davidkreidler/OpenCO2_Sensor/font/bahn.png

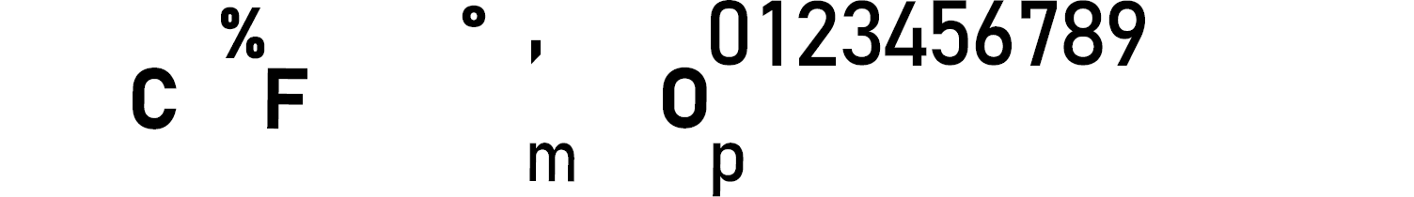
font/bahn.png
