davidkreidler/OpenCO2_Sensor/pictures/flowchart.png

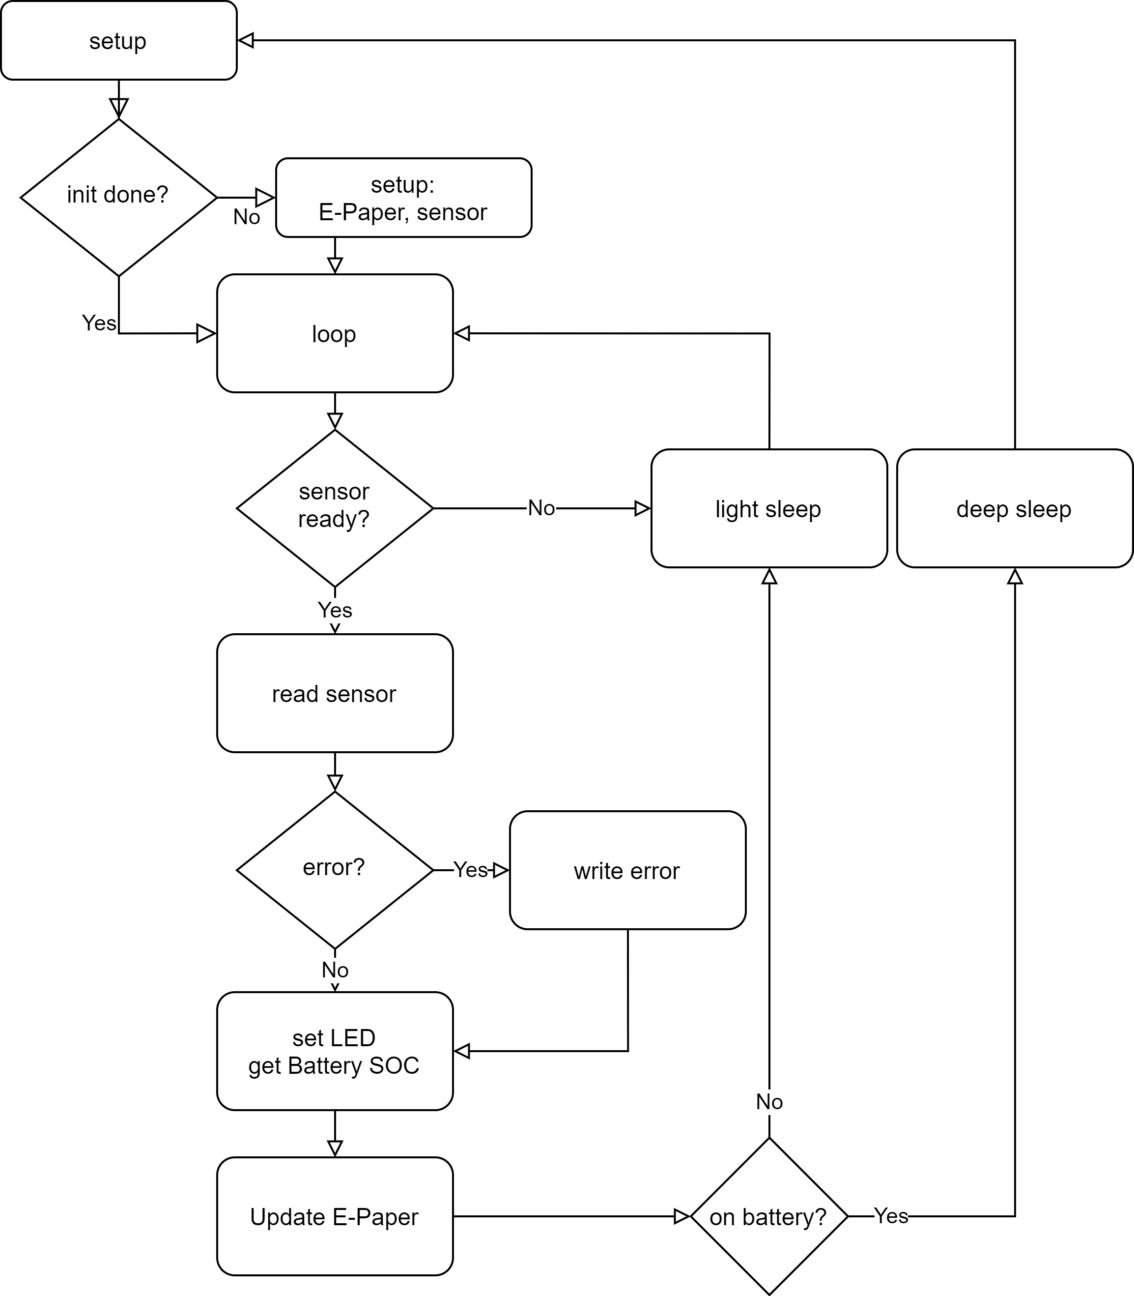
pictures/flowchart.png
