davidkreidler/OpenCO2_Sensor/pictures/header2.png

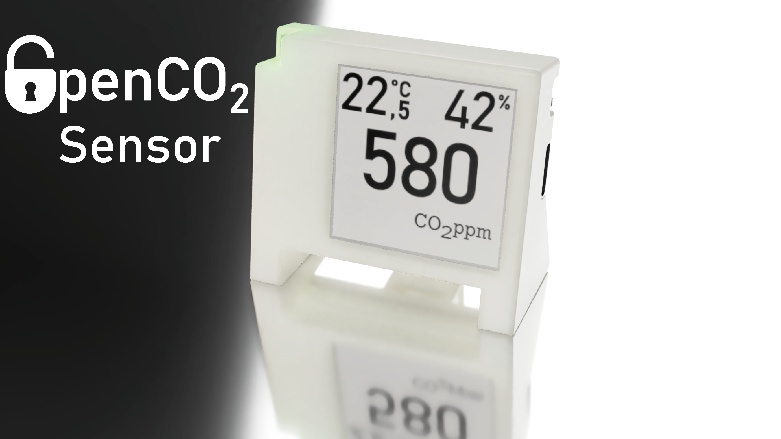
pictures/header2.png
