davidkreidler/OpenCO2_Sensor/pictures/components.png

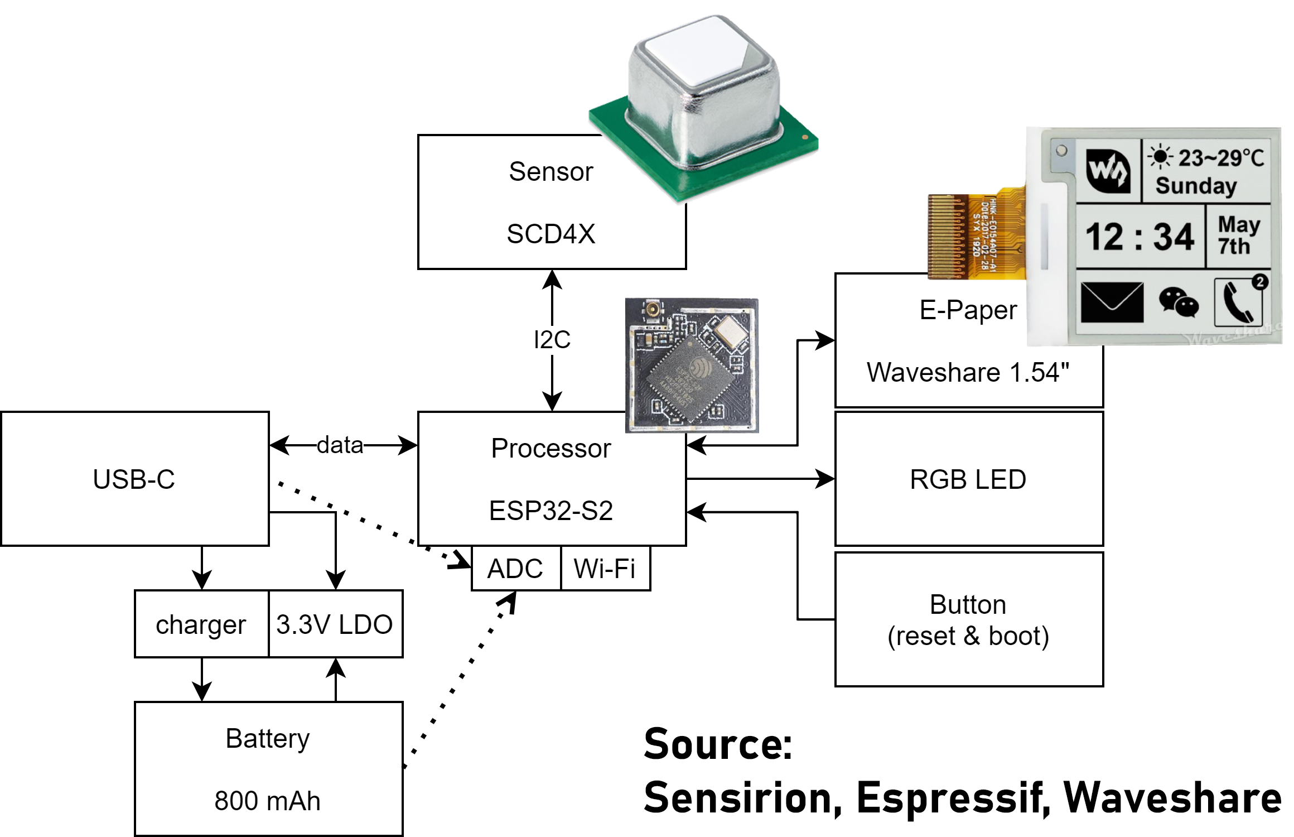
pictures/components.png
