davidkreidler/OpenCO2_Sensor/case/BACK.obj

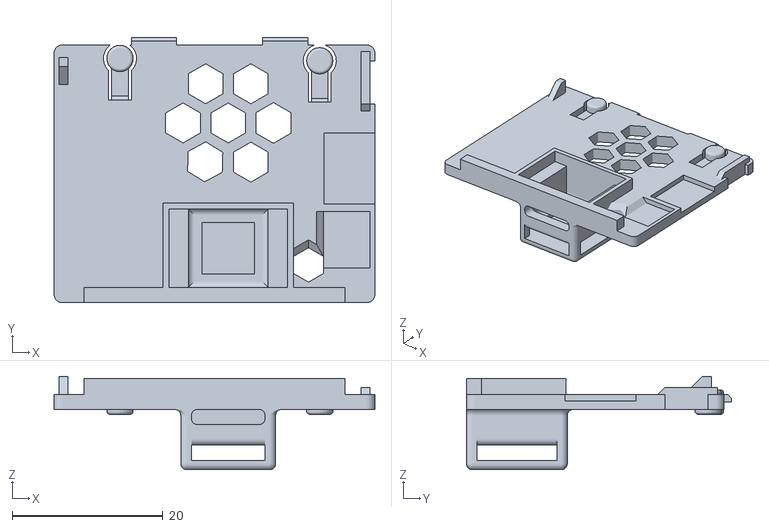
[picture p14: CAD file, 2023-07-02]
case/BACK.obj
42.6 x 35.2 x 12.4
