davidkreidler/OpenCO2_Sensor/case/FRONT.obj

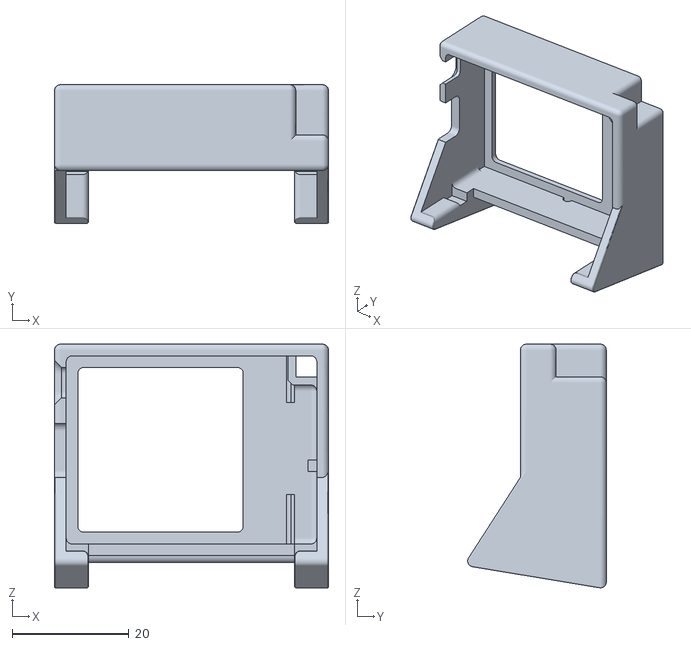
[picture p15: CAD file, 2023-07-02]
case/FRONT.obj
46.9 x 23.7 x 41.7
