davidkreidler/OpenCO2_Sensor/(threads)

Thread 2 (2022-03-26):

LED gets glitched into beeing on, but not reacting to co2 measurements. In BatteryMode.

Maashkinoozhe, 2022-03-26:
The led get stuck with a color and will not change until its reconnected to charging cable.
The software version is the one the sensor came with.
I have not done updates yet.

How to reproduce.

1. Sensor is disconnected from charging cable, LED is off.
2. Connect sensor with charging cable.
3. Disconnect charging cable as soon as the led switches on.

Expected Results:
1. Led stays on and changes color according to co2 measurements OR
2. Led turns off again and stays off

Actual Result:
Led stays on, even without charging cable.
Led color does not align with co2 values(co2 value changes, led color does not).
Led color is stuck on whatever color it had when "quick disconnecting" the sensor.

Closed 2022-10-02.

Thread 3 (2022-03-31):

getDataReadyFlag not found

chrho, 2022-03-31:
Hallo,

 wenn ich den main branch nehme und wie in der Readme beschrieben die Libs über die Arduino IDE installiere bekomme ich beim bauen die Fehlermeldung das es die Funktion nicht gibt. Ich hab auch in den Code der Lib geschaut da ist sie nicht enthalten. Kannst du mir sagen was ich falsch mache?

Gruß Christoph

davidkreidler, 2022-03-31:
Hey @chrho,
das ist eine sehr hilfreiche frage! Du benötigst die neuste Version der arduino scd4x Library:
github.com/Sensirion/arduino-i2c-scd4x in folgendem commit wurde die Funktion umbenannt:
https://github.com/Sensirion/arduino-i2c-scd4x/commit/4ec07965f30f32f4320960a04aadb7a19e6499c7

Einfach als ZIP downloaden und in der Arduino IDE importieren oder in den libraries Ordner entpacken.

Gruß
David

Closed 2022-10-02.

Thread 7 (2023-03-07):

where to order the sensor SCD40

volthouse, 2023-03-07:
where to order the sensor SCD40?

Thanks Volthouse

davidkreidler, 2023-03-07:
Hello @volthouse that is depending on how you want to use it.
There are development/breakout boards:
https://www.sparkfun.com/products/18365
https://www.adafruit.com/product/5187
https://sensirion.com/de/produkte/katalog/SEK-SCD41/

Or from [aliexpress](https://de.aliexpress.com/item/1005003974569988.html) **"SCD40 module"**

Its also possible to order the raw Sensor and solder it to a self designed PCB.

There is also the option to order the whole Open CO2 Sensor from [Tindie](https://www.tindie.com/products/davidkreidler/open-co2-sensor/). The next series with 150 devices is expected to arrive in April. Please join the waitlist if you are interested.

Thanks! David

Closed 2023-03-23.

Thread 9 (2023-04-15):

Sensor calibration

crener, 2023-04-15:
Hello,
Found this on Tindie and am extremely interested as this is something that I've wanted to build myself.

As I was looking at the sensor documentation to figure out what I would have todo to make it myself (was looking at the SCD41) I saw that there was an api for `set_sensor_altitude` (datasheet section 3.6.3) and `set_ambient_pressure` (section 3.6.5) each which calibrates the sensor so that it can perform higher accuracy measurements.

Is this something that is taken into account?

I was looking at the board and didn't see any pressure measurement sensors, for my project I was planning on using BMP384 to get this information... if this is something thats taken into account I would just buy yours on Tindie :)

davidkreidler, 2023-04-15:
Hey @crener thanks for reaching out. I take the sensor altitude into account here https://github.com/davidkreidler/OpenCO2_Sensor/blob/main/OpenCO2_Sensor.ino#L200 .
By default, it is set to 50 m above NN (because I'm from Berlin). This can be simply changed by you in the code and programmed into the sensor.

Air pressure is am interesting additional point! I I would highly encourage you to build a DIY version with a esp32 development board, a Waveshare 1.54" display, a SCD41 dev board and an air pressure sensor to find out potential benefits of this additional measurement.

In general the accuracy of the SCD40  is ±(50 ppm + 5% MV) @400-2000 ppm wich is more than enough to determine indoor air Quality (when to open a window). The Open CO2 Sensor also uses automatic self calibration by default to prevent potential long term drift. For this the Sensor needs ambient air exposure once peer week to automatically calibrate itself.

It would also be possible to by the Open CO2 Sensor on Tindie and add an external pressure sensor to the i2c bus here:
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

I hope this helps!
David

crener, 2023-04-16:
I guess it depends how much of an impact this has.

I think if it's noticeable people who use this in a tall building might have issues if the floor they are in is more than X meters above the ground (assuming that the setting is changed in their OpenCO2 unit).

Easy test might be to put two next to each other one with a 50m setting and another with 250m and see if the values are the same over the course of a day? I don't have any hardware on hand to build this (more of a software guy) so would take me a while to get an answer...

ThomasWaldmann, 2023-04-19:
Related article: https://gaslab.com/blogs/articles/altitude-compensation-co2-sensors

So it seems like a sensor calibrated at sea level (0m altitude) would display about 1% CO2 too much per additional 100m of altitude.

crener, 2023-04-19:
Hmm interesting read, for me that level of accuracy is fine with the default  but would make this unsuitable for people in mountains who aren't comfortable changing code and compiling to get a better base configuration for their location.

If you live in the Alps your village could be 1500m in elevation which would make all readings quite inaccurate.

Though i don't think anyone expects absolute accuracy from something like this, maybe the buttons on the back could be repurposed for some basic configuration?

davidkreidler, 2023-04-20:
Thanks for jumping on this discussion. The Building measurement idea would be defeated be the accuracy of the scd40 Sensor itself ±(50 ppm + 5% MV). At a 200m Height difference the difference would be 2% according to ThomasWaldmanns commend.

If you live in the Alps the automatic self calibration (ASC) of the SCD40 Sensor by Sensirion (a Swiss company) would do a great job in slowly adjusting to the Height. It needs to be exposed to ambient air.  This mode is enabled by default on my OpenCO2 Sensor.

 From the Datasheet:
"Field Calibration
To realize high initial and long-term accuracy, the SCD4x includes two field calibration features. [...] Automatic self-calibration (ASC) ensures highest long-term stability of the SCD4x without the need of manual action steps from the user. The automatic selfcalibration algorithm assumes that the sensor is exposed to the atmospheric CO2 concentration of 400 ppm at least once per
week."

ThomasWaldmann, 2024-05-04:
Is there a way to calibrate to 430ppm instead of 400ppm?

davidkreidler, 2024-05-04:
@ThomasWaldmann currently the calibration via the Menu ->Calibrate is defining the Environment to have 420ppm
https://github.com/davidkreidler/OpenCO2_Sensor/blob/v4.4/OpenCO2_Sensor.ino#L435
It can be changed there and then flashed onto the OpenCO2 Sensor.

For the automatic self calibration I sadly don't have the insides to know what the target is.

ThomasWaldmann, 2024-05-05:
Interesting that it is 420, my devices showed 400 after the calibration process with v4.4 (that's why I asked). Thanks for the pointer to where it can be adjusted.

Closed 2023-07-25.

Thread 10 (2023-07-21):

Font generation

volthouse, 2023-07-21:
Hello, with which tool can you generate your own fonts or convert free fonts?

davidkreidler, 2023-07-21:
Hey @volthouse thanks for reaching out. Its a bit more involved.

First, you can use the the template https://github.com/davidkreidler/OpenCO2_Sensor/blob/main/font/bahn.indd to insert your own font in the right size (3 times).
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

Then export it as png and use https://github.com/ayoy/font2bytes to convert it to binary.
./f2b -h 70 -w 47 bahn.png > bahn_big.cpp
./f2b -h 44 -w 29 bahn2.png > bahn_mid.cpp
./f2b -h 22 -w 13 bahn3.png > bahn_sml.cpp

Then import the result into you Arduino\libraries folder esp32-waveshare-epd\src\bahn*.cpp (it needs to be tweaked slightly).

If you have any questions please feel free to reach out.

volthouse, 2024-01-07:
Thank you for your reply, I apologise for my late reply, I have only just started working on my project again.

I am not familiar with INDD files, is it correct that it is an Adobe InDesign file format? Do I need Adobe software for this?

Many thanks for your help!

davidkreidler, 2024-01-08:
Yes the format is Adobe InDesign. You can also use any other Grafik Programm to create the Images for your font in the right format for https://github.com/ayoy/font2bytes .

Closed 2023-09-02.

Thread 12 (2023-11-06):

MQTT support

P1-Ro, 2023-11-06:
Would it be possible to add MQTT support? That way it could be easily connected to Home Assistant.

davidkreidler, 2023-11-06:
Hello @P1-Ro & thank you for reaching out regarding this.
Generally MQTT support is implemented but not jet fully validated.
I would appreciate your support regarding this a lot.

Currently its enabled via a special firmware or via your own build by enabling it here: https://github.com/davidkreidler/OpenCO2_Sensor/blob/main/OpenCO2_Sensor.ino#L40C10-L40C10
Please then also comment out "#define airgradient" and use esp board version 2.0.13

How to install it:
1. Download "OpenCO2_Sensor.ino.bin" from https://drive.google.com/file/d/1W8UEv53j-Czv9JsQuHC9AA_DrWFvl-n6/view?usp=sharing
2. Enable WiFi via the Menu on the OpenCO2 Sensor. Then connect a client to the new WiFi Network "OpenCO2 Sensor".
3. Navigate in your Webbrowser to http://192.168.4.1 (It also opens automatically on modern smartphones)
4.  Under Update select the OpenCO2_Sensor.ino.bin file and click Update. The Sensor will restart.

Connect again to the "OpenCO2 Sensor" network and insert your home network credentials and MQTT settings under "Configure WiFi".
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

P1-Ro, 2023-11-08:
Super stoked about that. I'll let you know when I have time for it :)

ThomasWaldmann, 2024-05-07:
Currently playing around with the MQTT enabled firmware, but already run into a problem:

The device was previously joined to a WiFi (so it does not open its own AP and show up under 192.168.4.1 any more), but I can ping it's home wifi IP.

How do I get the WiFiManager configuration web form now to enter the MQTT data? It does not seem to listen on port 80.

Thread 13 (2023-11-14):

Menue is not available and implausible Measurement

kraukl, 2023-11-14:
On my CO2-Sensor its impossible to engage the menue. Pressing the button on the back near the on/off switch (in battery mode or loading mode) only toggles LED on/off. In my printed mini-manual this button is called No.7 "LED On/Off".
Obviously my device is not the model that is described and shown online now. On my device there is an additional Reset button No. 8 which forces an instant measurement. I tried several different combinations of managing the 3 switches No. 6,7,8 without getting in the menue.

I wanted to update the device because the measurement behaviour is not sufficient. After storing in fresh air it shows 420-450 ppm and afterwords in the freshly ventilated room  it is creeping up implausibly quick and high. After moving it for testing into an airsealed and fresh air containing screwglass the CO2 raises up from initially 420 ppm to more than 2000ppm within 2 hours. It behaves in the sealed Glass as if its producing CO2 itself.

USB-Connection to my PC only affects a connection sound on the PC and no device shows up in the file manager.

I bougt the device at Tindie on 21 April 2023, Invoice No. #389420.
What can I do?

davidkreidler, 2023-11-14:
Hello @kraukl and thanks for reaching out and testing already.

To enable the Menu please update to the latest release (because it was developed after your purchase):
Instructions: https://github.com/davidkreidler/OpenCO2_Sensor#update-via-usb

Step by step:
- Download all files from the latest [release](https://github.com/davidkreidler/OpenCO2_Sensor/releases)
- Make sure, that the power switch is in the ON position (down)
- Plug a data USB-C cable (not the magnetic one) into your PC and the Sensor
- Hold the Button on the backside of the CO2 Sensor near the USB-C port and shortly push simultaneously the reset ↪️ Button
- In Windows Device Manager (Gerätemanager) under Ports (COM & LPT) find the COM number and modify it in update.bat
- Run update.bat via double click
- Afterwards push the reset ↪️ Button

This is only needed once. Afterwards or on new sensors its possible to update the Sensor over WiFi.
If you have any questions please feel free to reach out.

After the update its possible to do a manual calibration via the Menu (please put the Sensor outside while doing so).
Generally the CO2 level can rise quite quickly depending on factors like: How big is the room, how high is the sealing, how airtight is the room, how many people are in the room and for how long it was ventilated.
But you are right : during 2h in an air sealed container it should not rise. Only possibility I see is because CO2 is heavier then air it was collecting over time in the bottom close to the Sensor.

If these steps dont fix the observed behavior please reach out here and I will do an in depth analysis.
For this I then would like to kindly ask you to shipp the device to me. I will provide you a shipping label.

Thank you!
David

kraukl, 2023-11-17:
Thankyou david,
the update now worked.

But the unplausible measurement is still lasting.

Attached my handwritten 30 hrs log of a test in an airsealed 150ml screwglass after calibration in fresh air.
The CO2-Display raised from initially 446ppm to a maximum of 1488ppm after 19hrs.
Afterwards it gradually fell down furtheron to about constant 1000 to 1200ppm.

At first I assumed a faulty temperature compensation, but this obviously is not the reason (see temperatures & humidity values).

I would appreciate sending the device to you for a checkup as you kindly offered to me.

Best regards, manfred tischer

----------------------------------------------------------------------

Dienstag, 14. November 2023, 19:25:27, schriebst Du:

> Hello @kraukl and thanks for reaching out and testing already.

> To enable the Menu please update to the latest release (because it was developed after your purchase):
> Instructions: https://github.com/davidkreidler/OpenCO2_Sensor#update-via-usb

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

> This is only needed once. Afterwards or on new sensors its possible to update the Sensor over WiFi.
> If you have any questions please feel free to reach out.

> After the update its possible to do a manual calibration via the Menu (please put the Sensor outside while doing so).
> Generally the CO2 level can rise quite quickly depending on factors like: How big is the room, how high is the sealing, how airtight is the room, how many people are in the room and for how long it was ventilated.
> But you are right : during 2h in an air sealed container it should not rise. Only possibility I see is because CO2 is heavier then air it was collecting over time in the bottom close to the Sensor.

> If these steps dont fix the observed behavior please reach out here and I will do an in depth analysis.
> For this I then would like to kindly ask you to shipp the device to me. I will provide you a shipping label.

> Thank you!
> David

davidkreidler, 2023-11-29:
Evaluated the device and could not see a significant increase of CO2 inside a IKEA sealed container over 24h.
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

Also a comparison to a 3rd party device and a second sensor showed a static difference (likely doe to calibration).
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

One potential root cause of the increased CO2 Values was found in a call: The shift to colder temperatures because of the Winter season. This could have lead to a closed windows in the corridor. I will close the ticket for now.

kraukl, 2023-12-07:
Danke, das Gerät ist angekommen.

Herzlichen Dank für Ihre Bemühungen

Manfred Tischer

-----------------------------------------------------------
Mittwoch, 29. November 2023, 23:48:48, schriebst Du:

> Evaluated the device and could not see a significant increase of CO2 inside a IKEA sealed container over 24h.
> 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

> Also a comparison to a 3rd party device and a second sensor showed a static difference (likely doe to calibration).
> 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

> One potential root cause of the increased CO2 Values was found in a call: The shift to colder temperatures because of the Winter season. This could have lead to a closed windows in the corridor. I will close the ticket for now.

--
Mit freundlichen Grüßen,
Manfred Tischer

Closed 2023-11-29.

Thread 14 (2023-12-07):

Revised PCB

Blanketier, 2023-12-07:
I have run out of projects that I can make without spending an ungodly amount of money in R&D and me and a friend thought it would be fun if we mapped out the CO₂ monitor you have posted. You did not post the files for the schematic and board and only posted the images. looking at the schematic I have decided to just make a revised schematic with better power infrastructure and a few other misc. improvements. I was wondering if there is anyway to get in contact with you for you to explain some of your design choices?

davidkreidler, 2023-12-08:
Hey here is a good player to ask questions and I would love to see the power infrastructure changes. Thanks! David

Blanketier, 2023-12-08:
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
is the purpose of this section to switch between battery operated and usb powered depending on weather usb is plugged in?

davidkreidler, 2023-12-08:
Yes and to detect if USB is plugged in to go out of battery mode.

davidkreidler, 2023-12-09:
That's all parity Standart stuff. Almost every esp32 dev board uses these cheap components to protect the battery and only use it if USB is disconnected. The MOSFETs is conduction if USB is disconnected. And the diode otherwise powers the device. Using an expensive and not at my supplier lcsc available part is no improvement.

Closed 2023-12-17.

Thread 15 (2024-05-04):

update scripts for firmware 3.3 and 4.3 on POSIX OSes

ThomasWaldmann, 2024-05-04:
I finally updated my devices to the current firmware and had to make scripts for macOS due to the different executable name, usb-serial port name, UNIX style line endings, different needs for argument quoting, etc.

Guess if one changes the port name (which one has to check anyway), they would also work on Linux, BSD, etc.

I successfully tested them on a MacBook Pro with Apple Silicon here, but guess they also work on Intel. The scripts are based on the original `update*.bat` for Windows.

I also added some docs at the top of the scripts.

I had some v2.x devices, first upgraded to v3.3 (not sure if necessary), then upgraded to v4.3 using these scripts and a USB-C cable.

To upgrade to v4.4, I then used the OTA web-based firmware upload method via WiFi.

## update_fw_3.3_wifi_macos.sh
```
## Updating the OpenCO2 sensor to firmware release 3.3 (with wifi) on macOS.
# 0. download all the .bin files of the 3.3 release from github releases page and put them into current directory.
# 1. brew install esptool    (or somehow else have a working esptool.py)
# 2. OpenCO2 sensor: press and hold the button close to the usb port, then shortly press the reset button on the other side.
# 3. execute this script.
esptool.py --chip esp32s2 --port /dev/tty.usbmodem01 --baud 921600 --before default_reset --after hard_reset write_flash -z --flash_mode dio --flash_freq 80m --flash_size 4MB 0x1000 OpenCO2_Sensor.ino.bootloader.bin 0x8000 OpenCO2_Sensor.ino.partitions.bin 0xe000 boot_app0.bin 0x10000 wifi.bin
```
## update_fw_4.3_wifi_macos.sh
```
## Updating the OpenCO2 sensor to firmware release 4.3 (with wifi) on macOS.
# 0. download all the .bin files of the 4.3 release from github releases page and put them into current directory.
# 1. brew install esptool    (or somehow else have a working esptool.py)
# 2. OpenCO2 sensor: press and hold the button close to the usb port, then shortly press the reset button on the other side.
# 3. execute this script.
esptool.py --chip esp32s2 --port /dev/tty.usbmodem01 --baud 921600 --before default_reset --after hard_reset write_flash -z --flash_mode dio --flash_freq 80m --flash_size 4MB 0x1000 OpenCO2_Sensor.ino.bootloader.bin 0x8000 OpenCO2_Sensor.ino.partitions.bin 0xe000 boot_app0.bin 0x10000 OpenCO2_Sensor.ino.bin
```

davidkreidler, 2024-05-04:
Thank you very much for sharing the details on how to update under macOS using esptool.
This process was not scalable at none tech enthusiastic costumers. For all (new) devices running V4.4+ when they get connected via USB to a computer they emulate an USB flash drive to enable copy pasting of [FIRMWARE.BIN](https://github.com/davidkreidler/OpenCO2_Sensor/releases/download/v4.4/FIRMWARE.BIN)

Closed 2025-01-26.

Thread 18 (2024-05-20):

Several reboots during charging (v4.5)

nm, 2024-05-20:
After upgrading to v4.5, I have experienced several reboots during charging. Everything is fine in battery mode.
After downgrading to v4.4 the reboots are gone.

Does anyone else have this problem?
Maybe related to https://github.com/davidkreidler/OpenCO2_Sensor/commit/e351ebc04f1215ceaa1af4050829d22f6743a42b?

davidkreidler, 2024-05-20:
Hey @nm thanks for updating to the latest version and sharing your experience. The commit you shared is only active in battery mode when going to deep sleep...

Most likely the instability is related to an updated ESP32 boards version to
"Arduino Release v2.0.16 based on ESP-IDF v4.4.7".
arduino-esp32 https://github.com/espressif/arduino-esp32/compare/2.0.13...2.0.16

Here is a OpenCO2 v4.5 build based on ESP "Arduino Release v2.0.13":
https://drive.google.com/file/d/1mw3rHz8mlEjAy6Y1W7xySc4TDw19aKiD/view?usp=sharing

Would you please flash it and report back if the issue is fixed?

Thanks!
David

nm, 2024-05-22:
Thanks @davidkreidler,
with the updated build the issue is fixed.

davidkreidler, 2024-05-22:
Perfect thanks for confirming. I will debug this further.

Closed 2024-05-22.

Thread 19 (2024-06-22):

Please add `LICENSE` file to repository

penyuan, 2024-06-22:
Thanks for making this amazing open source CO2 sensor! Just ordered one on Tindie, can't wait to receive it soon. ❤️

Can @davidkreidler please include a `LICENSE` file in this repository? GitHub has [easy steps](https://docs.github.com/en/communities/setting-up-your-project-for-healthy-contributions/adding-a-license-to-a-repository) for doing so, and there are [hardware-specific open source licenses](https://choosealicense.com/non-software/) such as [CERN-OHL-S-2.0](https://choosealicense.com/licenses/cern-ohl-s-2.0/).

Happy to send a Pull Request if helpful.

Thanks!

davidkreidler, 2024-06-25:
Hey @penyuan thank you for your purchase! Ive added a MIT licence in this commit: https://github.com/davidkreidler/OpenCO2_Sensor/commit/a705ffd5d7deb6f2e755a6baa1590b5d50c6ddbf

David

penyuan, 2024-06-25:
> Hey @penyuan thank you for your purchase! Ive added a MIT licence in this commit: [a705ffd](https://github.com/davidkreidler/OpenCO2_Sensor/commit/a705ffd5d7deb6f2e755a6baa1590b5d50c6ddbf)
>
> David

Awesome, thank you so much! 🙇🏼‍♂️

Closed 2024-06-25.

Thread 20 (2024-06-26):

Bigger clock

saviola777, 2024-06-26:
Hello, great little device!

How difficult would it be to add a setting to have a bigger clock at the bottom, replacing the "12:31 <WiFi-Symbol> co2ppm"? Both the wifi symbol and the co2ppm are kind of unnecessary to me (the former since the clock is only shown when connected to wifi anyway, the latter because well, I know the units!). As it is, the clock is a bit hard to read for someone without perfect vision (like me).

Of course nobody else might be interested in something like this so it might not be worth it. If that's the case, maybe you could give me some pointers how to implement something like that myself? (I do have a computer science background, but have never worked with ESP / Arduino IDE etc.)

Thanks!

PS: I don't really want to open another issue for this because it's not really a problem, just something maybe worth documenting: after opening/closing the menu, calibration, reboots etc., all sensor values (mostly temperature and humidity) are random and several hours to slowly come back to the correct values. It's not a big deal, but it seems like something easily fixed by starting from the last known values?

davidkreidler, 2024-06-26:
Hey @saviola777 , thanks for reaching out and Im always happy about improvement suggestions.
The size and position of the time is programmed here: https://github.com/davidkreidler/OpenCO2_Sensor/blob/main/epd_abstraction.ino#L951
The WiFi Symbol is programmed just above it. I've made the change for the next upcoming release:
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

You can download a preview firmware here: https://drive.google.com/file/d/1CZV0PkfPjihIBflSv7b6Stn6vJallcpi/view?usp=sharing
Install it by plugging in a data USB-C cable into your PC and the Sensor. Then copy FIRMWARE.BIN to the USB device.

Regarding the temperature and humidity values: Because of self heating of the whole sensor when WiFi is activated a relatively large temperature offset of 13°C is applied automatically when WiFi is active. Without WiFi only a 4.4°C offset is applied.
On Battery the offset is only 0.8°C. https://github.com/davidkreidler/OpenCO2_Sensor/blob/main/OpenCO2_Sensor.ino#L174

Since this self heating takes some time the temperature and humility values might be off after a cold start.  If you know any possibility to decrease the power consumption of the ESP32 using WiFi as a client, I would appreciate the help. Switching to matter or esphome might improve this. But with less convenience access to the values and the initial WiFi setup.

saviola777, 2024-06-27:
Awesome, thank you! Works like a charm. I guess it makes sense with the heat, I did not think about that at all.

I had it running overnight on battery and it showed 16°C and 10% humidity this morning (real values were closer to 26.5°C and 60%, unfortunately). Maybe that was also related to the offset somehow? But I'm planning to have it run on power constantly anyway (connected to the USB port of my FritzBox), or would you recommend against that because of power usage?

While powered, the temperature seems to be off by about -1°C, humidity by +5% (if I can trust the readings of this other sensor which I'm not sure about), which is within an acceptable range (and something I could manually fix by changing the offset in the code once I figure out how to build the firmware myself).

I suppose I could disable WiFi, but I really like that clock. :smile:

davidkreidler, 2024-06-29:
As I understand you had it on Battery over night and then plugged it in? Then the temperature was then lower then expected. If yes, this is exactly what the offset causes. Its applied instantly but the device was not heated up jet.

The specs for accuracy are:
Temperature ±0.8°C
Humidity ±6%

Instructions for setup the programming Environment can be found here:
https://github.com/davidkreidler/OpenCO2_Sensor?tab=readme-ov-file#installation-inside-the-arduino-ide

Running it plugged in to your fritzbox is totally fine. Power consumption is about 0,1 Watt or while charging up to 3 Watt. For long long term usage like this you could think about charging the battery to around 60% and then unplugging it.

saviola777, 2024-07-03:
As a small addendum: I tested it without WiFi and the values for both temperature and humidity are now exactly the same as on my other sensors. I guess the offsets for WiFi don't work in all situations (for me it was always temperature 0.8-1.0° too high and humidity 4-5% too low), or maybe it needs a linear offset depending on measured values, I don't know.

I decided to give up on the clock for now and run without WiFi, maybe one day I'll set up a development environment and tinker with different offsets.

davidkreidler, 2024-07-03:
Hey @saviola777 thanks for the follow up. I did a deep dive and build a debug firmware that shows the applied offset in the Menu -> Info point. By doing this I found a but that was introduced in v4.6 with the faster wifi response time.
The change from usb power mode to battery mode lead to a case where the offset was not applied because comingFromDeepSleep was set incorrectly (because there was no new measurement value after 500ms).

Fix:
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

Now the offset is correctly applied when going into Batery mode.

Also compared the temperature while using wifi and you are correct. Compared to a reference device I could see a about 0.8°C difference. Likely root cause of the lower offset requirement is that I switched from 240MHz to 80MHz mode. The new offset will be allied in the next release:
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

Thank you for pointing out these bugs! Here is a preview:
https://drive.google.com/file/d/1StSAuJfoRrM6ONd-Y4JslkN3VltMClaX/view?usp=sharing

saviola777, 2024-07-04:
Awesome, thanks! Temperature now within 0.3 of the other sensor which is great. Humidity is off by 6% (too high), do you have an explanation for that? Does the sensor use the measured temperature to determine the humidity or something which leads to wrong values with the WiFi heat? Do we need an offset here as well?

It's not a big deal of course, and it's also possible my other sensor is wrong, but without WiFi the humidity readings were within 1% from the other sensor.

davidkreidler, 2024-07-07:
The claimed accuracy of the scd40 sensor by sensirion  is +-6% for humidity. So this would be within spec. Inside the scd40 itself it's only possible to set a temperature offset it also affects the calculation for the humidity.

Hope this helps!
David

saviola777, 2024-07-07:
Yeah that's fine. I just find it weird that it's always exactly +4-6% above my other sensor when on WiFi and within +-1% of the other sensor when without WiFi. I guess it would be simple to alter the recorded/displayed humidity reported by the sensor depending on the WiFi status, maybe I'll try to make that change.

davidkreidler, 2024-07-07:
Go for it! If you need help please ask.

Closed 2024-06-27.

Thread 21 (2024-07-21):

Document how to extract current sensor values programmatically

saviola777, 2024-07-21:
Hello,

this is probably trivial to figure out if one knows anything about Prometheus/Grafana, but maybe it would be useful to document how to use `curl` / `wget` or similar to extract current sensor values from the device over WiFi in a machine-readable format.

The website is cool and all, but I would prefer to integrate the information directly into my system to e.g. remind me to open/close the windows depending on sensor values and inside/outside temperatures.

davidkreidler, 2024-07-21:
Hey @saviola777 thanks for reaching out. Great suggestion to add a quick how to get values instructions.

First please find out the IP of the sensor in your home network via the ui of your router or on the sensor itself via the button under Menu -> Info .

Then insert the IP here and use
`wget -S -O - [IP]:9925/metrics`

Or `wget [IP]:9925/metrics
cat metrics`

Or via curl example

`curl 10.0.0.101:9925/metrics`
```
# HELP rco2 CO2 value, in ppm
# TYPE rco2 gauge
rco2{id="Open CO2 Sensor",mac="7C:DF:A1:96:B9:72"}571
# HELP atmp Temperature, in degrees Celsius
# TYPE atmp gauge
atmp{id="Open CO2 Sensor",mac="7C:DF:A1:96:B9:72"}25.37
# HELP rhum Relative humidity, in percent
# TYPE rhum gauge
rhum{id="Open CO2 Sensor",mac="7C:DF:A1:96:B9:72"}55.15
```

Hope this helps, I will add it to the README

David

saviola777, 2024-07-21:
Perfect! Thanks.

Closed 2024-07-21.

Thread 22 (2024-07-28):

Wifi not available on battery ?

YannDanthu, 2024-07-28:
Hello,

first of all thank you for making the OpenCO2 sensor.

Quick question related to the wifi, as it is only available while on power and not on battery.
Is this because of energy consumption ?

Also, while on power the temperature is messed up and not accurate anymore, probably by the heat generated by the charging battery.

Do you plan to allow wifi on battery in the future ?

davidkreidler, 2024-07-28:
Hey @YannDanthu  thanks for reaching out.

The current Wi-Fi implementation is only active if power is connected. You are correct this is for energy saving reasons. There are no hardware limitations that limit the activation on Battery, but a good energy saving implementation like ESP-NOW would be recommended.

There is one esphome implementation by Yourigh available with some limitations (no LED / Menu / limited Fonts)
https://github.com/Yourigh/OpenCO2_Sensor_esphome/tree/main

Other then that my main focus until now was not on enabling WiFi on Battery. This is because the use case was to use the OpenCO2 Sensor on Battery while being on the go and plugging it back in when coming Home, automatically enabling WiFi.

While charging elevated temperatures are expected because of the used TP4065 which lowers the 5V USB Voltage to the current Battery voltage via dissipating heat. Charging from empty to full should be completed after less then 1:50 h.

Hope this helps,
David

YannDanthu, 2024-07-28:
thanks for the answer.

One last question, I didn't dig into it yet but would it be easy to publish the metrics to an endpoint from the CO2Sensor (instead of pulling from another device)

Thread 23 (2024-11-04):

FIY: Homeassistant configuration

Finkregh, 2024-11-04:
I added this config to the `configuration.yml` of my homeassistant.

You can use https://www.uuidgenerator.net/version4 to generate your own individual IDs and assign an area in the UI after a reload.

```yaml
rest:
    scan_interval: 60
    resource: http://IPADDRESSorHOSTNAME:9925/
    method: GET
    sensor:
      - name: "NAME Co2"
        device_class: carbon_dioxide
        unique_id: "d611314f-9010-4d0d-aa3b-37c7f350c82f"
        value_template: >
            {{ value | regex_findall_index("(?:rco2.*})(\d+)") }}
      - name: "NAME Temperature"
        unique_id: "d611314f-9010-4d0d-aa3b-37c7f350c821"
        device_class: temperature
        value_template: >
            {{ value | regex_findall_index("(?:atmp.*})((?:\d|\.)+)") }}
      - name: "NAME Humidity"
        unique_id: "d611314f-9010-4d0d-aa3b-37c7f350c822"
        device_class: humidity
        value_template: >
            {{ value | regex_findall_index("(?:rhum.*})((?:\d|\.)+)") }}
```

Further documentation:
- https://www.home-assistant.io/integrations/rest/
- https://www.home-assistant.io/integrations/sensor.rest

Feel free to add it to the readme or where appropriate. Thanks for your work <3

davidkreidler, 2024-11-09:
Hey @Finkregh and thank you very much for sharing the Home Assistent config.
Ive added it to the readme with some minor changes: First I added a general hostname in v5.4: "openco2".
In newer Versions there is also a graph website under that main URL and the Maschine readable one is http://OpenCO2:9925/metrics

https://github.com/davidkreidler/OpenCO2_Sensor/commit/25bb626ea4bfb275eadd7216eeef7a7a6f9cd242

Ruinenlord, 2025-02-18:
Hello,

I, as a beginner, read in different forums about the rest integration and tried everything to add more than one sensor to Home Assistant. A single one works fine, but I'm not able to modify the code without getting errors "duplicate mapping key".

I would like to read the dates from three sensors.

Could anyone modify the code for me? Thanks a lot for helping.

Finkregh, 2025-02-18:
Did you generate individual uuids?

Ruinenlord, 2025-02-19:
This is one part, I was wondering about. How can I define unique IDs for every sensor?

davidkreidler, 2025-02-19:
In the script by Finkregh above there are example values in the unique_id field. I think you can freely define your own as long as they are different for every Sensor / value. You also need to add each unique IP address in the resource field.

In the API I'm also providing the Mac address of every Sensor example:

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

Ruinenlord, 2025-02-19:
Ok, thank you, I will have a try.

Closed 2024-11-09.

Thread 26 (2025-01-21):

FR: Manual IP settings

mikispag, 2025-01-21:
It would be cool to allow manual IP settings (IP, gateway, DNS) instead of forcing DHCP. I believe WifiManager has an example set for this use case, so it should not be too hard to implement.

davidkreidler, 2025-01-21:
Hey @mikispag thanks for reaching out.
I see the option to set a static IP at compile time in the wifimanager here:
https://github.com/tzapu/WiFiManager/blob/master/examples/Advanced/Advanced.ino#L57
There is also the option to "show static IP/DNS fields" below. But for normal costumers this might be a bit complex.

For a test Ive added it here:
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
Result is this field on the wifi connect page:
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

If you would like to trial it here is the binary:
https://drive.google.com/file/d/1Iz7nN6zynmJLcX0xWQRZ1jldBMAmfOK_/view?usp=sharing

Hope this helps,
David

mikispag, 2025-01-21:
Wow, that was fast! Thank you very much, David.

I believe showing the fields in a collapsible way (hidden under a "Static IP settings" or "Advanced IP settings") should not be too bad for regular users, but it's your call!

Two questions: could you make the binary in English and how do I forget the saved WiFi info (reset)? I didn't find documentation about this.

davidkreidler, 2025-01-21:
The language can be change on the Sensor itself via the Menu -> Display -> German/English
The easiest way to "forget" the stored WiFi is to just walk away from the position where the known Wifi is active. Otherwise the only current way is to use the Arduino IDE Option under Tools -> "Erase All Flash Before Sketch Upload" -> Enabled.

Welcome!

mikispag, 2025-01-21:
Thanks, works perfectly. Could also delete the WiFi config in the Info section of the portal.

Cheers!

Closed 2025-01-21.

Thread 27 (2025-02-21):

WPA3

darksnakezero, 2025-02-21:
Very sorry to contact you this way, but the tindie website refused to let me contact you directly.

Is the sensor able to connect to a WPA3 wifi network?

davidkreidler, 2025-02-21:
Hey @darksnakezero thanks for reaching out normally tindie has a kind of forum to exchange messages. But here is also a good place to reach out.

Yes, the ESP32-S2 I use has this on its Feature List https://docs.espressif.com/projects/esp-idf/en/latest/esp32s2/api-guides/wifi.html#esp32-s2-wi-fi-feature-list
- WPA/WPA2/WPA3/WPA2-Enterprise/WPA3-Enterprise/WAPI/WPS and DPP

At home I use WPA3 in transition mode on my Fritzbox without issues.

Closed 2025-02-24.

Thread 28 (2025-02-23):

Influence of humidity on CO2 concetration measurement

saviola777, 2025-02-23:
Hello again,

I wanted to ask if you have any information on the effect of relative humidity on the measured CO2 concentration for the employed sensor?

For a couple of months I had very low humidity (~30%) in my apartment and I noticed that the measured CO2 concentration seemed much lower than before (after ventilating for ~10 minutues in the morning I could go 8+ hours and it would still show less than 1000ppm). Now I have a (fan-based) humidifier and the humidity is back to around ~45% and around 3 hours after ventilating the apartment down to ~600ppm the CO2 concentration is at 1100ppm.

davidkreidler, 2025-02-24:
Hey @saviola777 thanks for reaching out, again :D
The SCD40 has an included humidity/temperature sensor to compensate this for accurate CO2 measurements. According to the Datasheet: "Accuracy can be reduced at relative humidity levels lower than 10%.". And:

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

Maybe in your case there are other factors at play like for example a tiny gap in one of the Window seals or an open window in the hallway?

Also if after 3 hours of (across?) ventilation only 600ppm is reached I would recommend a re calibration via the Menu by placing the sensor outside and after a few minutes start the re calibration. Automatic self calibration is enabled by default but maybe there was an Event, bringing it out of spec.

Closed 2025-02-24.

Thread 31 (2025-05-12):

Stuck in TEST_MODE (?) after update to 5.6

jujupsy, 2025-05-12:
Hello,

I have just updated the firmware to 5.6 via USB.
However, I now see the voltage and other information (MAC address and serial) instead of the time / battery.

I already tried to flash it with the Arduino IDE (settings: Erase all Flash enabled & USB Firmware MSC enabled), but that didn't change anything.

Looking at the code, I'm assuming it has to do with TEST_MODE, but I'm not sure.

Any help or ideas to fix this are greatly appreciated :)

davidkreidler, 2025-05-12:
Hey @jujupsy thanks for reaching out. To exit TEST_MODE: please push the button while the sensor is in Battery mode. This will trigger displayWelcome() and write the EEPROM value. https://github.com/davidkreidler/OpenCO2_Sensor/blob/main/OpenCO2_Sensor.ino#L778

David

jujupsy, 2025-05-12:
Perfect! That worked!

Many thanks for the very quick reply.

Closed 2025-05-12.

Thread 35 (2025-07-01):

stuck on welcome screen after update to 5.7

xBorsti, 2025-07-01:
Hi,

my unit is stuck on the welcome screen, the one with the House and the stopwatch, after updating to 5.7 via USB. Same happens on 5.6 and 5.5. i did not try to go any lower, cause it seems like a deeper problem.

If i push the button on the back and exit the menu the sensors stay at 400ppm the clock gets updated but nothing else.

If i activate WLAN i also cant connect to openco2:9925 but have to use my IP:9925, but that may be another Problem.

Is there a way for me to reset the unit and start over?

xBorsti, 2025-07-01:
Hi thanks for the help, i bought the unit on 27th of June.

Closed 2025-07-01.

Thread 36 (2025-07-25):

Can't reach the device

andreapx, 2025-07-25:
Hi, sorry to write here, but I don't have any other contacts.
I've bought your device, I've set it up, I can ping it, but I can't connect to port 9925. It doesn't even respond to telnet.
What can I check?
Thanks!

davidkreidler, 2025-07-25:
Hey @andreapx here is exactly the right place to reach out regarding software topics.
MQTT is currently not activated by default, but you can use the Maschine readable UI under
http://openco2:9925/metrics
OR http://[IP]:9925/metrics
The IP can be found by pressing the Menu button on the back of the OpenCO2 Sensor and navigating to Info.

There is only an early beta implementation of MQTT. But it was not tested jet. In case you would like to trial it:
Please recompile via Arduino IDE with this enabled: https://github.com/davidkreidler/OpenCO2_Sensor/blob/main/OpenCO2_Sensor.ino#L52
and this commented out: https://github.com/davidkreidler/OpenCO2_Sensor/blob/main/OpenCO2_Sensor.ino#L44
Then, in the wifi setup assistant website you find the field for the IP.

If your goal is to include the OpenCO2 Sensor into your home assistant please just follow the instructions here: https://github.com/davidkreidler/OpenCO2_Sensor/tree/main?tab=readme-ov-file#home-assistant

regards,
David

Thread 37 (2025-07-30):

Device doesn't connect to hidden network

andreapx, 2025-07-30:
Hi!
I've noticed that the device doesn't connect to hidden network.
I've created an IoT WiFi network, I've connected the device to it and all was good.
I've then hidden the WiFi network and as soon as I've restarted the CO2 device it didn't connect anymore to the network.
Can this problem be solved?

davidkreidler, 2025-07-30:
Hey @andreapx to connect to WiFi the [WiFiManager](https://github.com/tzapu/WiFiManager) library is used. For hidden SSIDs, you must manually specify the SSID and password, as the ESP32 cannot detect the network during a scan. Please try to setup your hidden SSID via the portal again.

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

andreapx, 2025-07-31:
@davidkreidler I've hidden the network after I've connected the device.
I all was working and when I've hidden it and restarted the devices, it didn't reconnect anymore to the network.

davidkreidler, 2025-07-31:
Yes I've got that. My assumption is, that after the visibility flag of the SSID changed, it needed to be setup again in the OpenCO2 Sensor. Please try to set it up again. Otherwise creating an issue in the  wifimanger repro might be the way to go.

Closed 2025-09-16.

Thread 40 (2025-08-29):

humidity constantly rising

xBorsti, 2025-08-29:
Hi,

one of my three units does not measure humidity very well. Its constantly rising till it reaches 100%. Then after some time it shuts down and stops sending measurements.

Is the unit broken? or is there a way to reset the humidity sensor?

its a newer Model, bought in July, and it only starts with Firmware 5.8

Protarios, 2025-09-16:
Hi, have kind of the same problem.
The sensor is always above 80% humidity and alsontemp is 4°C off.
Recieved the sensor this week and also calibration does not help.

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

davidkreidler, 2025-09-16:
Hey @Protarios depending on the Environment (especially on WiFi: based on airflow and signal strength) the default Temperature offset might needs to be adjusted. https://github.com/davidkreidler/OpenCO2_Sensor/blob/main/OpenCO2_Sensor.ino#L320
On WiFi the default one is 12.2°C. In your case 8.7°C might be best. This also affects the humidity calculation.

Regarding the calibration: its only affecting the CO2 Value.

Here https://drive.google.com/file/d/1aH6IWMQoNFT6ZVr_A-WsNftiHss08SzY/view?usp=sharing is a Firmware build with that offset. Please update the OpenCO2 Sensor by connecting it with the switch in the OFF position via a data USB cable to your PC. Afterwards switch it to on and copy the FIRMWARE.BIN to the USB-Storage device. Thanks!
