davidkreidler/OpenCO2_Sensor/esp32-waveshare-epd/src/DEV_Config.cpp

/*****************************************************************************
* | File      	:   DEV_Config.c
* | Author      :   Waveshare team
* | Function    :   Hardware underlying interface
* | Info        :
*----------------
* |	This version:   V1.0
* | Date        :   2020-02-19
* | Info        :
#
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
******************************************************************************/
#include "DEV_Config.h"
#include <SPI.h>

void GPIO_Config(void)
{
    pinMode(EPD_BUSY_PIN,  INPUT);
    pinMode(EPD_RST_PIN , OUTPUT);
    pinMode(EPD_DC_PIN  , OUTPUT);
    
    //pinMode(EPD_SCK_PIN, OUTPUT);
    //pinMode(EPD_MOSI_PIN, OUTPUT);
    pinMode(EPD_CS_PIN , OUTPUT);

    //digitalWrite(EPD_CS_PIN , HIGH);
    //digitalWrite(EPD_SCK_PIN, LOW);
}
/******************************************************************************
function:	Module Initialize, the BCM2835 library and initialize the pins, SPI protocol
parameter:
Info:
******************************************************************************/
UBYTE DEV_Module_Init(void)
{
	//gpio
	GPIO_Config();

    SPI.begin(EPD_SCK_PIN, -1, EPD_MOSI_PIN, -1);  //sck,miso,mosi,ss
    SPI.beginTransaction(SPISettings(2000000, MSBFIRST, SPI_MODE0));

	//serial printf
	//Serial.begin(115200);

	// spi
	// SPI.setDataMode(SPI_MODE0);
	// SPI.setBitOrder(MSBFIRST);
	// SPI.setClockDivider(SPI_CLOCK_DIV4);
	// SPI.begin();

	return 0;
}

/******************************************************************************
function:
			SPI read and write
******************************************************************************/
void DEV_SPI_WriteByte(UBYTE data)
{
    //SPI.beginTransaction(spi_settings);
    digitalWrite(EPD_CS_PIN, GPIO_PIN_RESET);
    SPI.transfer(data);

    /*for (int i = 0; i < 8; i++)
    {
        if ((data & 0x80) == 0) digitalWrite(EPD_MOSI_PIN, GPIO_PIN_RESET); 
        else                    digitalWrite(EPD_MOSI_PIN, GPIO_PIN_SET);

        data <<= 1;
        digitalWrite(EPD_SCK_PIN, GPIO_PIN_SET);     
        digitalWrite(EPD_SCK_PIN, GPIO_PIN_RESET);
    }*/

    //SPI.transfer(data);
    digitalWrite(EPD_CS_PIN, GPIO_PIN_SET);
    //SPI.endTransaction();	
}
