davidkreidler/OpenCO2_Sensor/pictures.c

#include "pictures.h"

const unsigned char gImage_init[5000] = { /*0X00,0X01,0XC8,0X00,0XC8,0X00,*/
0XFF,0XFF,0XFF,0XFF,0XFF,0XFF,0XFF,0XF7,0XF7,0XFF,0XFF,0XFF,0XFF,0XFF,0XFF,0XFF,
0XFF,0XFF,0XFF,0XFF,0XFF,0XFF,0XFF,0XFF,0XFF,0XFF,0XFF,0XFF,0XFF,0XFF,0XFF,0XFF,
0XE3,0XE3,0XFF,0XFF,0XFF,0XFF,0XFF,0XFF,0XFF,0XFF,0XFF,0XFF,0XFF,0XFF,0XFF,0XFF,
0XFF,0XFF,0XFF,0XFF,0XFF,0XFF,0XFE,0X0F,0XFF,0XE7,0XE3,0XFF,0XFF,0XFF,0XFF,0XFF,
0XFF,0XFF,0XFF,0XFC,0X00,0XFF,0XFF,0XFF,0XFF,0XFF,0XFF,0XFF,0XFF,0XFF,0XFF,0XE0,
0X0F,0XFF,0XE7,0XF3,0XFF,0XFF,0XFF,0XFF,0XFF,0XFF,0XFF,0XFF,0XF0,0X00,0X3F,0XFF,
0XFF,0XFF,0XFF,0XFF,0XFF,0XFF,0XFF,0XFF,0X00,0X0F,0XFF,0XE7,0XF3,0XFF,0XFF,0XFF,
0XFF,0XFF,0XFF,0XFF,0XFF,0XE0,0X00,0X1F,0XFF,0XFF,0XFF,0XFF,0XFF,0XFF,0XFF,0XFF,
0XFC,0X00,0X1F,0XFF,0XE7,0XF3,0XFF,0XFF,0XFF,0XFF,0XFF,0XFF,0XFF,0XFF,0XE1,0XFE,
0X1F,0XFF,0XFF,0XFF,0XFF,0XFF,0XFF,0XFF,0XFF,0XF0,0X00,0X0F,0XFF,0XE3,0XE3,0XFF,
0XFF,0XFF,0XFF,0XFF,0XFF,0XFF,0XFF,0XE3,0XFF,0X1F,0XFF,0XFF,0XFF,0XFF,0XFF,0XFF,
0XFF,0XFF,0XC0,0X00,0X7F,0XFF,0XF0,0X07,0XFF,0XFF,0XFF,0XFF,0XFF,0XFF,0XFF,0XFF,
0XE7,0XFF,0X1F,0XFF,0XFF,0XFF,0XFF,0XFF,0XFF,0XFF,0XFF,0X80,0X0F,0XFF,0XFF,0XF8,
0X0F,0XFF,0XFF,0XFF,0XFF,0XFF,0XFF,0XFF,0XFF,0XE3,0XFF,0X1F,0XFF,0XFF,0XFF,0XFF,
0XFF,0XFF,0XFF,0XFE,0X00,0X7F,0XFF,0XFF,0XFF,0XFF,0XFF,0XFF,0XFF,0XFF,0XFF,0XFF,
0XFF,0XFF,0XE0,0X00,0X1F,0XFF,0XFF,0XFF,0XFF,0XFF,0XFF,0XFF,0XFC,0X01,0XFF,0XFF,
0XFF,0XFF,0XFF,0XFF,0XFF,0XFF,0XFF,0XFF,0XFF,0XFF,0XFF,0XE0,0X00,0X3F,0XFF,0XFF,
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
0XFF,0XFF,0XFF,0XFF,0XFF,0XFF,0XFF,0XFF,0XFF,0XFF,0XFF,0XFF,0XFF,0XFF,0XFF,0XFF,
0XFF,0XFF,0XFF,0XFF,0XFF,0XFF,0XFF,0XFF,0XFF,0XFF,0XFF,0XFF,0XFF,0XFF,0XFF,0XFF,
0XFF,0XFF,0XFF,0XFF,0XFF,0XFF,0XFF,0XFF,0XFF,0XFF,0XFF,0XFF,0XFF,0XFF,0XFF,0XFF,
0XFF,0XFF,0XFF,0XFF,0XFF,0XFF,0XFF,0XFF,};
