davidkreidler/OpenCO2_Sensor/pictures.h

#ifndef _IMAGEDATA_H_
#define _IMAGEDATA_H_

extern const unsigned char gImage_init[];
extern const unsigned char gImage_welcome[];
extern const unsigned char gImage_rainbow[];
extern const unsigned char gImage_santa[];

#endif
