davidkreidler/OpenCO2_Sensor/(commit log)

2021-09-03 add PCB picture
2021-09-03 README pcb picture
2021-09-14 dont print dataReadyErrorCount
2021-09-14 modify waveshare libary
    add Font "bahn"
    pinout for ESP32-S2
    keep Display data in sleep memory
    remove debug & unused header files
2021-11-28 Wifi & Fixes
    Support Wifi with easy setup. Known Issue: Crash after deep sleep
    temperature offset adjustment
    esp_sleep_pd_config() API changes by espressif
    remove app push notification code
    LED: add blue variable; add magenta for high co2
    waveshare: fix compiler warning regarding __utility/EPD_H_
    [DEV_Config.h]
2021-12-11 Layout + E-Paper (update & only when co2 +-10ppm)
    Layout fix for:
    co2 > 9999 ppm
    temperature <10 °C
    Full E-Paper refresh every hour / six hours, on battery
    No partial update directly after full update needed
    No E-Paper update on Battery, unless co2 is +- 10 ppm different
2021-12-12 Flash the binary
    Option, to flash the precompiled binary.
    Please see README.md: "Flash the binary to the CO2-Sensor"
2021-12-12 Bugfix: allways refresh on going to Battery Mode
    Initialize Battery mode correctly, only then save as much energy as possible.
2022-01-10 Battery % calibration & optimization
    offset for type of Battery used (110 mV)
2022-02-28 V2.0: waveform, refactoring, cleanup, getDataReadyFlag
    - refactoring: ideas from @japhsc
    (header, clean up, whitespaces, outsource to functions)
    - support newest Sensirion/arduino-i2c-scd4x with getDataReadyFlag
    - E-Paper ESP32 Driver Board Code update (14 February 2022)
    including timing and new waveform
    - E-Paper use native SPI functions with adjusted pins
    - variable deep sleep time
    - delete binaries -> use GitHub Releases
    - delete E-Paper examples
2022-02-28 Update README.md
    update esp32S2 install instructions & binary flashing from Releases
2022-03-08 Button enables LED in Battery mode
    Use IO0 (BOOT) Button in deep sleep to toggle LED enable
    Spelling
    Whitespaces
2022-05-22 TEST_MODE & HWSubRev 2 support
    TEST_MODE: SCD4x/led self-test, battery voltage and USB power
    HWSubRev 2: power display and LED only when needed; different Battery Voltage divider
2022-06-20 new UI, pictures, HW2 bugfixes
    UI: Battery position + percent; add “CO2” lettering
    invert display option
    Flowchart & components picture
    HWSubRev 2:
    field battery % calibration
    Bugfix:
    Display: write previous Image to display RAM after power cut
    LED: active in Battery mode not reliable fixed
2022-07-03 Fix battery calibration
    use of Preferences to store max battery Voltage
2022-08-05 Separate display functions
    Simple abstraction of all display related functions (except power) into epd_abstraction.ino
2022-10-02 E-Paper ESP32 update from 11 August 2022
2022-10-10 Update for ESP32 Arduino 2.0.5
    Now supports ESP32 Arduino 2.0.5 based on ESP-IDF 4.4.2 by using rtc_gpio_pullup_dis on gpio for USB_PRESENT.
    Defines refactoring
    Source of esp32-waveshare-epd
2022-11-03 New fonts; 4.2" battery icon; temperature fix
    Add new fonts: gotham & nothing
    4.2" display gets a new battery icon & malloc fix
    fix temperature decimal place
    [epd_abstraction.ino]
2022-12-12 Case render update
2023-01-24 TEST_MODE: Serial Output & MAC
    Option to print all TEST_MODE data via Serial connection (CO2, temperature, humidity, Battery Voltage, Battery Mode, Sensor Selftest, Mac address and SCD4x Serial Number). These values will also be displayed on the e-ink screen.
2023-01-30 3D Case files
    3D print your own case
    Drawing overview
    [BACK.obj, FRONT.obj]
2023-01-30 Update README.md
    add links to 3D printing files
2023-02-20 Wi-Fi fixed & new display gen & low Battery voltage change
    Working Wi-Fi including initial setup portal, deep sleep and MQTT credentials preparation.
    Change low Battery voltage to 3.2V to prevent potentially missing to display warning.
    E-Ink:
    - Support new Waveshare Display generation (EPD_1IN54_V2_Init_Partial_After_Powerdown). Otherwise, the image might be flipped after deep sleep.
    - malloc fix (otherwise Paint_Clear writs to unknown memory)
    [epd_abstraction.ino]
2023-03-05 README.md: how to update the Sensor
2023-03-06 fix temperature update in Battery mode
    While the sensor is in Battery mode the display was only updated if the CO2 value changed by 10ppm. This was due to conserving energy. Now the display will be updated, if the temperature changes by 0.5°C.
2023-03-14 E-Ink after power connected fix; calibrate_co2 option
    After connecting power, the display glitched for a few partial update cycles. Fixed by doing a full refresh.
    Option to calibrate_co2, only enable this if a calibration is needed!
    To calibrate, connect the Sensor to Power and let it run outside for 5 minutes.
    [epd_abstraction.ino]
2023-04-30 refactor TEST_MODE
    Use a variable instead of a define to enable easier exit via a button press after the production.
    To enable test mode:
    - enable "write HWSubRev 2" (only on hw 2)
    - Arduino: Erase All Flash Before Sketch Upload: "Enabled"
    - for Serial change: "USB CDC On Boot: "Enabled"
2023-04-30 Rainbow easter egg
    Press the LED button for 5 sec on battery to enjoy!
2023-04-30 only update in Battery mode if CO2 changed by 3%
2023-07-02 Update case 3D files
    BACK V13
    FRONT V23
    [BACK.obj, FRONT.obj]
2023-07-21 Font base data
    Use https://github.com/ayoy/font2bytes to convert the font to binary and import it into you Arduino\libraries folder esp32-waveshare-epd\src\bahn*.cpp (it needs to be tweaked slightly).
    ./f2b -h 70 -w 47 bahn.png > bahn_big.cpp
    ./f2b -h 44 -w 29 bahn2.png > bahn_mid.cpp
    ./f2b -h 22 -w 13 bahn3.png > bahn_sml.cpp
2023-07-29 QR code display the CO2 values over last 24h
    Press the button for 5+ seconds to show a QR code containing each the co2 values of 1h. Up to 24 QR codes will be stored. Measurements are only stored and displayed in battery mode.
2023-08-26 Add Menu
    Menu to choose between LED, Rainbow, Calibrate and History. Open the Menu via Button press and choose option via long press.
2023-08-28 Wi-Fi via menu & update README
    Enable Wi-Fi via the menu when the OpenCO2 Sensor is plugged in.
    A Wi-Fi network named 'OpenCO2 Sensor' will be enabled. Connect to it and navigate to http://192.168.4.1 . From there type in your home network credentials or OTA the Sensor.
2023-09-24 Menu bugfixes
    fix Menu Bugs like:
    - correct exiting (after 20 sec)
    - missed button presses
    - exit rainbow mode via button press
    [OpenCO2_Sensor.ino, epd_abstraction.ino]
2023-10-19 UI Update: Clock, Info, Wi-Fi bring up and German translation
    Wi-Fi onboarding improvements: Show a QR code to first quickly connect to the OpenCO2 Sensor. Afterwards when OpenCO2 Sensor is connected to a home Wi-Fi, a QR code with the IP and Port is displayed.
    New Menu point "Info": displaying mac Address, SCD4X Serial number, ESP32 Core temperature, up-time, Software Version, Battery Voltages and if connected to Wi-Fi: signal strength and IP.
    New on Wi-Fi: Display the Berlin NTP time.
    Optional: German translation
2023-10-22 LED Menu
    Choose the LED state on Battery and on USB Power separately.
    Choose the Brightness in 5 steps.
    Choose the Color scheme
    1=current smooth scale
    2=green until 600ppm, light green until 800ppm, orange until 1000ppm, dark orange until 1500ppm, red until 2000ppm and magenta above.
2023-12-25 Holiday Update v4.3
    New Easter Egg: Santa mode
    Menu improvement: register button press while display is updated
    WiFi Hostname in home network is now OpenCO2-SensorXYZ
2024-03-12 Fahrenheit, inverted Display & 4.2" bugfix
    Option to invert the Display and to use Fahrenheit via the Menu.
    Update for 4.2" eink display with bugfixes.
    airgradient/MQTT compiler warning.
    [OpenCO2_Sensor.ino, epd_abstraction.ino]
2024-05-05 v4.5 update libraries
    arduino-esp32 https://github.com/espressif/arduino-esp32/compare/2.0.13...2.0.16
    Adafruit_BusIO https://github.com/adafruit/Adafruit_BusIO/compare/1.15.0...1.16.0
    Sensirion Arduino Core Library https://github.com/Sensirion/arduino-core/compare/0.6.0...0.7.1
    WiFiManager https://github.com/tzapu/WiFiManager/compare/v2.0.16-rc.2...v2.0.17
2024-05-07 some small source code improvements (#16)
    * improve top comment
    - add headline
    - add name of mqtt library
    * cosmetic: unify comment style (blanks)
    * cosmetic: translate / fix typos
    * add HEIGHT_ABOVE_SEA_LEVEL [m] constant (use 50 for Berlin)
    * add TZ_DATA constant (with data for Berlin)
    [OpenCO2_Sensor.ino]
2024-06-25 v4.6 history graph and README update
    Go to Menu -> History to see up to 18h of CO2 or Temperature/Humidity measurements in a graph. Min/max/avg values will also be displayed. QR code order is inverted now for easier export.
    [OpenCO2_Sensor.ino, epd_abstraction.h, epd_abstraction.ino]
2024-06-25 fix build for v4.6
    [OpenCO2_Sensor.ino, epd_abstraction.ino]
2024-06-30 v5.0 new Website inc History
    Connect the OpenCO2 Sensor to your home Wi-Fi. Navigate to http://[IP]:9925 to view current values and an up to 24h history graph for CO2 (every 30 sec) and temperature / humidity (every 1.5 min).
    Enlarge Clock and move Wi-Fi Symbol
2024-07-03 Bugfix: temperature offset on Wi-Fi and in Battery mode
    [OpenCO2_Sensor.ino, epd_abstraction.ino]
2024-07-21 v5.1 Website improvements & bugfix
    Website improvements:
    - timesteps now get generated by the client by only transmitting start- and end time
    - transmit values in multiple buffers of data
    Update README for machine-readable Measurements
    Wi-Fi menu:
    - enable handleClient while displaying the IP
    - only start wifiManager when not on battery
    - update warning screen when power gets connected
    Display:
    - Refresh screen when rainbow mode is exited
    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
    [OpenCO2_Sensor.ino, epd_abstraction.ino]
2024-08-19 v5.2 WiFi reconnect & rewrite values save
    The OpenCO2 Sensor now auto reconnects if the WiFi connection is lost (for example a router reboot).
    Code refactoring: Rewrite how values are stored. Now up to 24h of measurements are stored in a ring buffer with automatic overflow handling. This replaces the more complex handling of 24 separate arrays containing measurements for 1h each.
    [OpenCO2_Sensor.ino, epd_abstraction.ino]
2024-10-10 v5.3 Website timing and History graph bugfix
    Website graph timing improvement: Store CO2 values exactly every 30 seconds.
    History graph:
    4.2" display now supports full screen.
    Bugfix for min Value.
    [OpenCO2_Sensor.ino, epd_abstraction.ino]
2024-11-09 V5.4 Snake & Home Assistant
    New FUN Menu including Snake
    Readme on how to add the OpenCO2-Sensor to Home Assistant. The hostname was changed to OpenCO2. This also enables http://openco2:9925
2024-12-10 enable ESP32 version update
    Remove not needed sleep parameters
    Because of the small ulp memory only stores temperature/humidity every 3 minutes.
    Todo: fix other storage limitations
    [OpenCO2_Sensor.ino, epd_abstraction.ino]
2026-06-28 ESP32 version Update 3.3.10 & storage fix
    Fix FastLED to library version 3.10.3 otherwise the storage is not sufficient
    [OpenCO2_Sensor.ino]
2026-09-28 v6.3 disable Access Point after connecting to WiFi
    also update to arduino-esp32 version 3.3.12
2026-10-14 update arduino_build.yml with bump esp32 3.3.12
    arduino_build.yml w still pins on ESP32 3.3.10
    in V6.3 you bumped to ESP32 3.3.12 board manager.
    One more thing: The README "Installation inside the Arduino IDE" section doesn't mention the core version, FadtLED 3.10.3, and the 8Mhz Core setting
    Adding those there would help doing the build manually in Arduino.
    The Hitchhiker greets!
